badgeteam/ecsc21-badge-public/README.md

# ecsc21-badge-public
Hardware design files for the ENISA ECSC21 badge (software coming later)
