badgeteam/ecsc21-badge-public/hardware/prod/3D renders/back.png

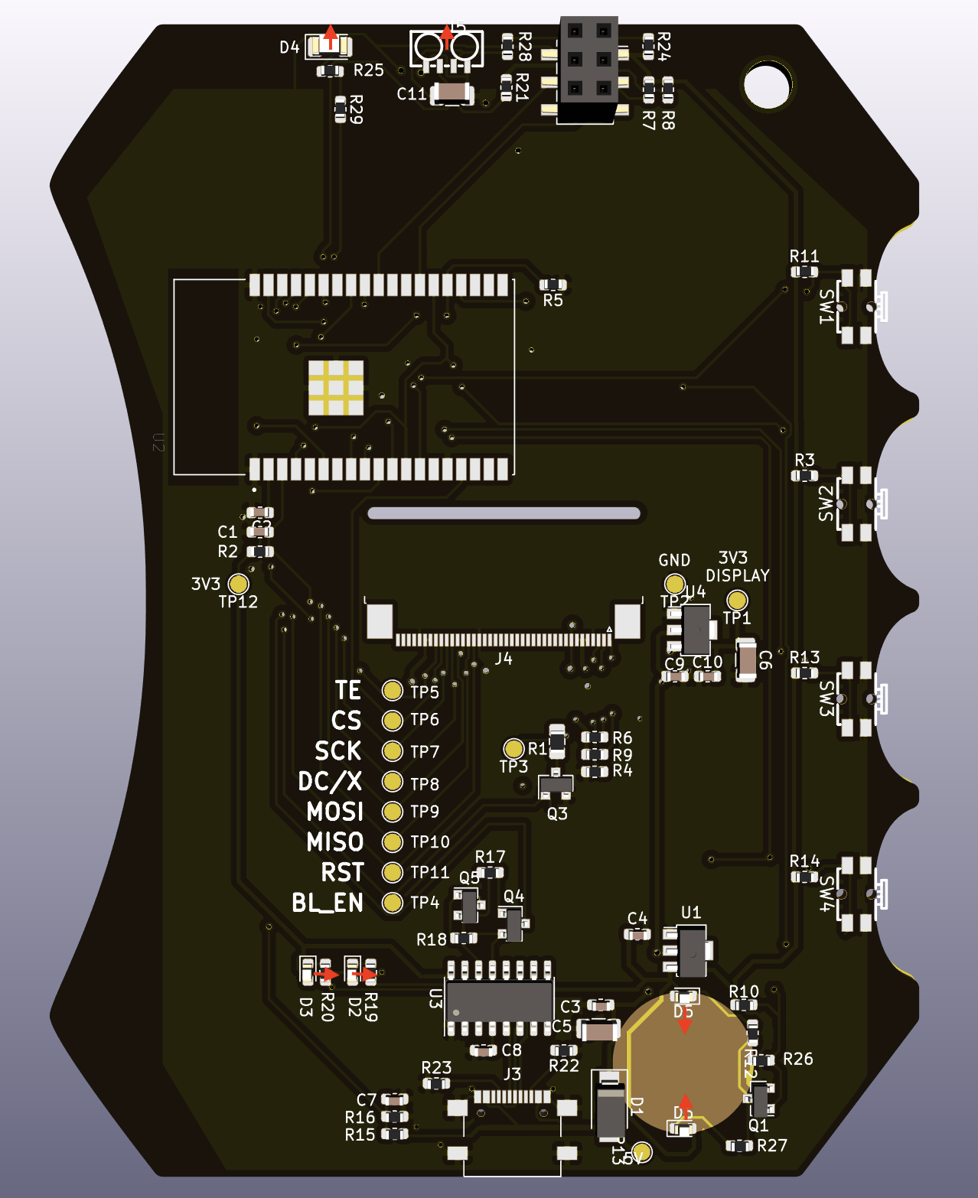
hardware/prod/3D renders/back.png
