badgeteam/ecsc21-badge-public/hardware/prod/3D renders/front.png

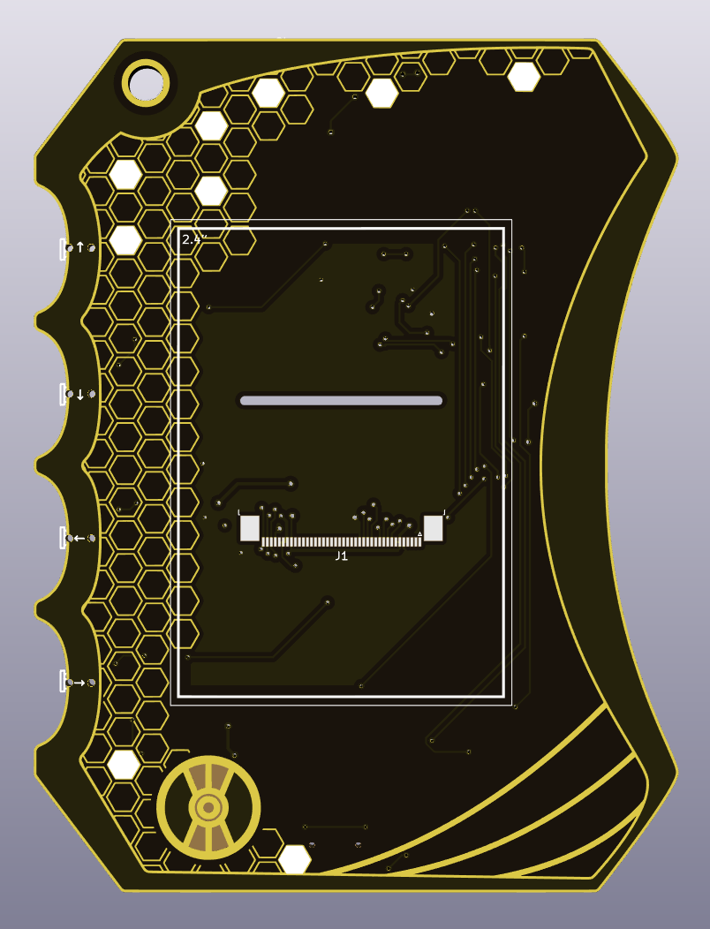
hardware/prod/3D renders/front.png
