badgeteam/ecsc21-badge-public/hardware/prod/BoM/ecsc21-badge.xlsx

Reference | Quantity | Value | Footprint | Datasheet | Notes
C1 C2 C7 C8 | 4 | 100nF | Capacitor_SMD:C_0603_1608Metric | ~
C11 | 1 | 10uF | Capacitor_SMD:C_1206_3216Metric | ~
C3 C4 C9 C10 | 4 | 1uF | Capacitor_SMD:C_0603_1608Metric | ~
C5 C6 | 2 | 10uf | Capacitor_SMD:C_1206_3216Metric | ~
D1 | 1 | 3A 0.5 Vf | Diode_SMD:D_SMA | https://lcsc.com/product-detail/Schottky-Barrier-Diodes-SBD_SS34_C183891.html
D2 | 1 | BLUE | LED_SMD:LED_0603_1608Metric | ~
D3 | 1 | GREEN | LED_SMD:LED_0603_1608Metric | ~
D4 | 1 | IR12-21C/TR8 | LED_SMD:LED_1206_3216Metric | https://datasheet.lcsc.com/szlcsc/1809192013_Everlight-Elec-IR12-21C-TR8_C53672.pdf
D5 D6 | 2 | Orange LTST-S270KFKT_C160472 | LED_SMD:LED_0603_1608Metric | https://datasheet.lcsc.com/szlcsc/Lite-On-LTST-S270KFKT_C160472.pdf
J1 J4 | 2 | Z240IT008 240x320 RGB TFT | Connector_FFC-FPC:TE_4-1734839-0_1x40-1MP_P0.5mm_Horizontal | See Nick's recommended connector, with the black securing tab at the bottom.
J2 | 1 | Conn_02x03_Counter_Clockwise | DNP | ~
J3 | 1 | USB_C_Receptacle_USB2.0 | Connector_USB:USB_C_Receptacle_China_SMT | https://www.usb.org/sites/default/files/documents/usb_type-c.zip
J5 | 1 | Conn_01x04_Female | OPTO-SMD_IRM-V840C_TR1:OPTO-SMD_IRM-V840C_TR1 | https://lcsc.com/product-detail/Others_Everlight-Elec-IRM-V840C-TR1_C264267.html
Q3 Q1 Q4 Q5 | 4 | AO3400 (A09T) | Package_TO_SOT_SMD:SOT-23 | http://www.aosmd.com/pdfs/datasheet/ao3400.pdf
R1 | 1 | 6.8 Ohm (1/4W) | Resistor_SMD:R_0805_2012Metric_Pad1.15x1.40mm_HandSolder | ~
R10 | 1 | DNP | DNP | ~
R2 R5 R15 R16 R11 R13 R14 R3 R4 R6 R9 R26 R21 R17 R18 | 15 | 10k | Resistor_SMD:R_0603_1608Metric | ~
R25 R24 R12 R27 R28 R29 | 6 | 47 Ohm | Resistor_SMD:R_0603_1608Metric | ~
R8 R7 R22 R23 R19 R20 | 6 | 5k1 | Resistor_SMD:R_0603_1608Metric | ~
SW1 SW2 SW3 SW4 | 4 | XUNPU TS-1014S-26 | SW-SMD_4P-L4.7-W4.5-P1.70-LS5.5-EH | https://lcsc.com/product-detail/Tactile-Switches_XUNPU-TS-1014S-26_C455255.html
U1 U4 | 2 | XC6206P332PR | Package_TO_SOT_SMD:SOT-89-3 | https://www.torexsemi.com/file/xc6206/XC6206.pdf
U2 | 1 | ESP32-WROOM-32D | esp32-wrover:XCVR_ESP32-WROVER | https://www.espressif.com/sites/default/files/documentation/esp32-wroom-32d_esp32-wroom-32u_datasheet_en.pdf | 4MB flash is fine
U3 | 1 | CH340C | Package_SO:SOIC-16_3.9x9.9mm_P1.27mm | https://www.mpja.com/download/35227cpdata.pdf
