badgeteam/ecsc21-badge-public/hardware/prod/pdf/ecsc21-badge-B_SilkS.pdf

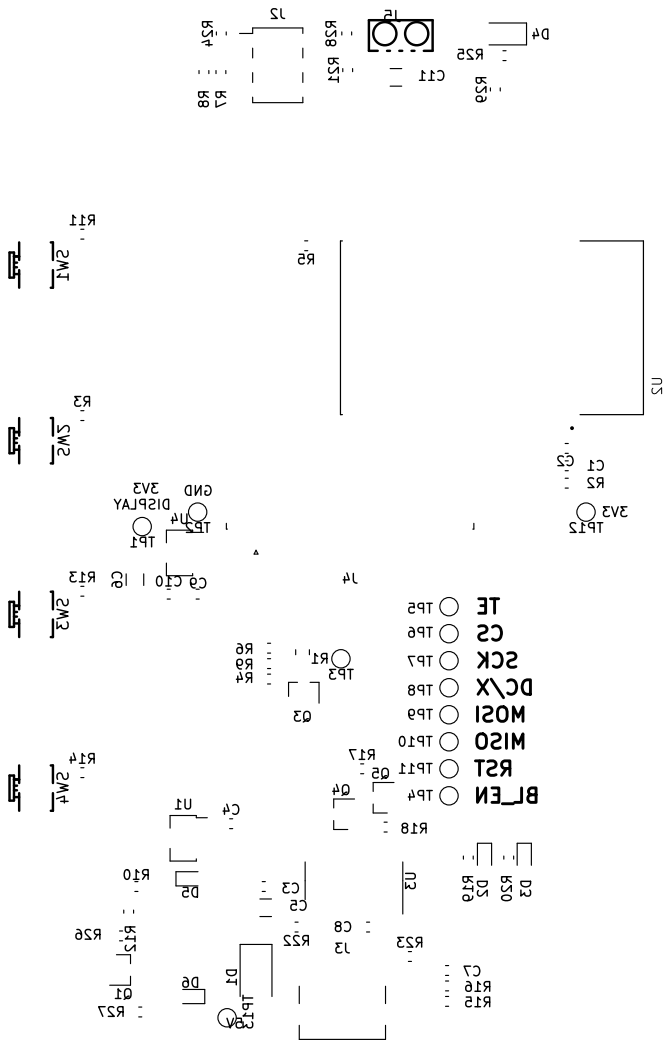
[picture p3: page 1]

GND RST MISO MOSI DC/X
