badgeteam/ecsc21-badge-public/hardware/prod/pdf/ecsc21-badge.pdf

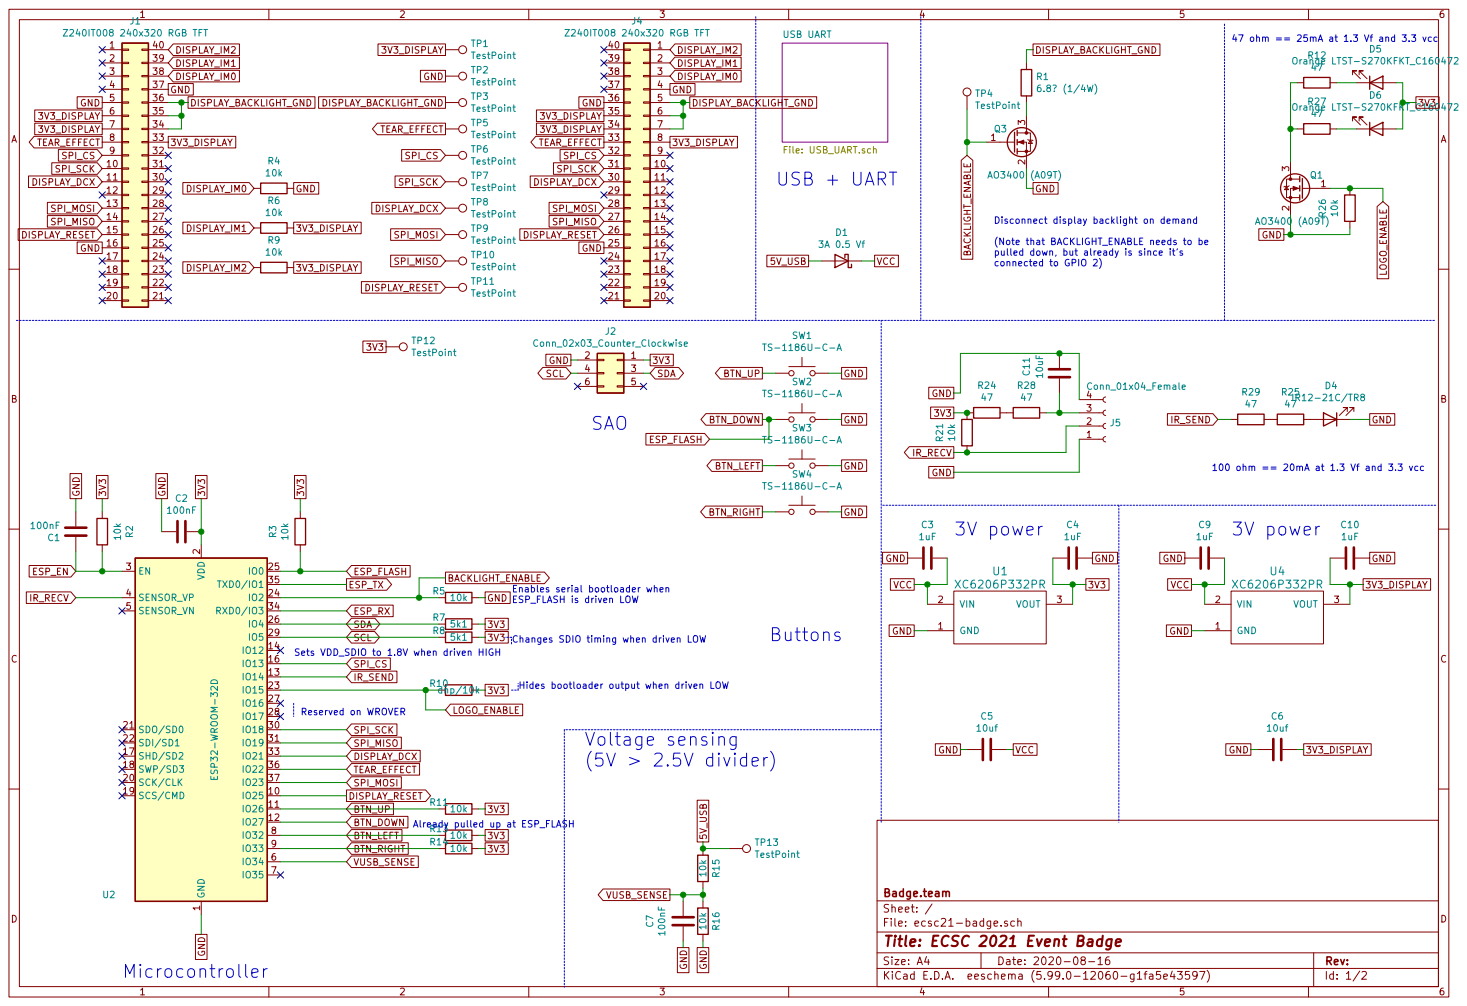
[picture p4: page 1]

47 ohm == 25mA at 1.3 Vf and 3.3 vcc

35 | 3V3_DISPLAY GND 6

Disconnect display backlight on demand

(Note that BACKLIGHT_ENABLE needs to be
connected to GPIO 2)

100 ohm == 20mA at 1.3 Vf and 3.3 vcc SAO

3V power Reserved on WROVER

2 SCK/CLK 20 SDO/SD0 21 SDI/SD1 22

Changes SDIO timing when driven LOW

Sets VDD_SDIO to 1.8V when driven HIGH

Hides bootloader output when driven LOW

Already pulled up at ESP_FLASH

File: ecsc21-badge.sch Sheet: / Badge.team

Id: 1/2 Title: ECSC 2021 Event Badge

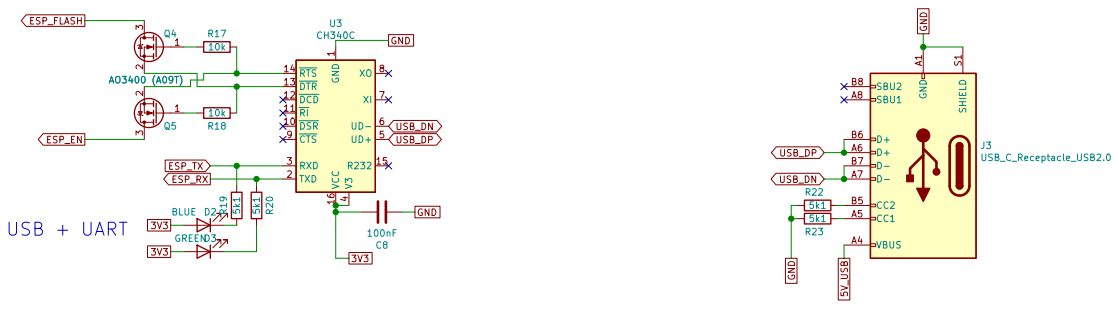
[picture p5: page 2]

4 UD+ 5 UD- 6 XI 7 XO 8 ~{CTS} 9 U3 CH340C GND A1 VBUS A4 CC1 A5 D+ A6 D- A7 SBU1 A8 CC2 B5 D+ B6 D- B7 SBU2 B8 SHIELD S1

1 ~{DSR} 10 ~{RI} 11 ~{DCD} 12 ~{DTR} 13 ~{RTS} 14 R232 15 VCC 16 TXD 2 RXD 3 V3

File: USB_UART.sch Sheet: /USB UART/ GREEND3 BLUE D2
