badgeteam/ecsc21-badge-public/hardware/prod/pdf/ecsc21-badge-B_CrtYd.pdf

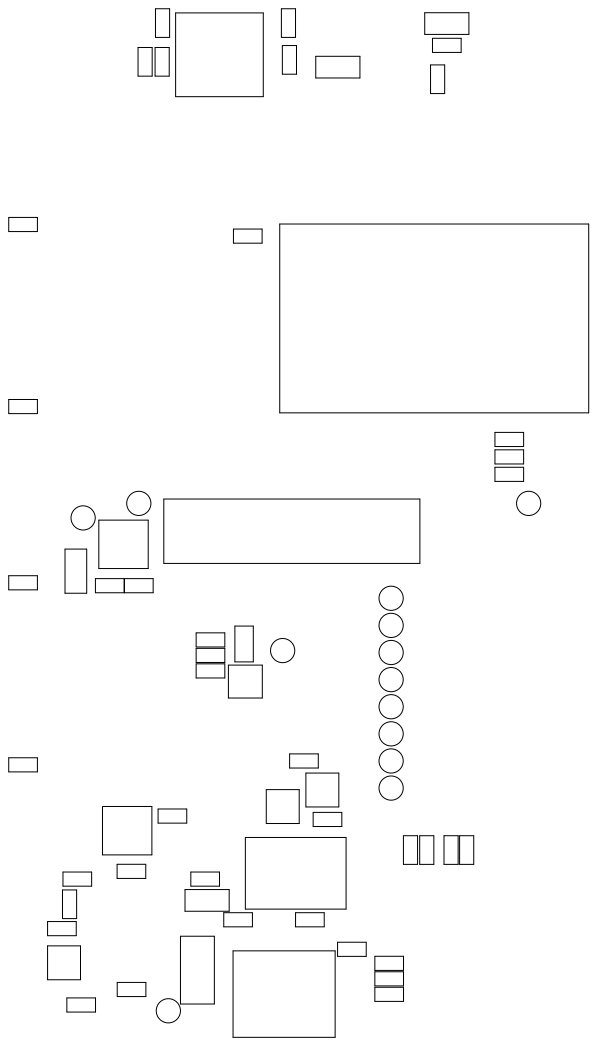
[picture p6: page 1]
