badgeteam/ecsc21-badge-public/hardware/prod/pdf/ecsc21-badge-B_Cu.pdf

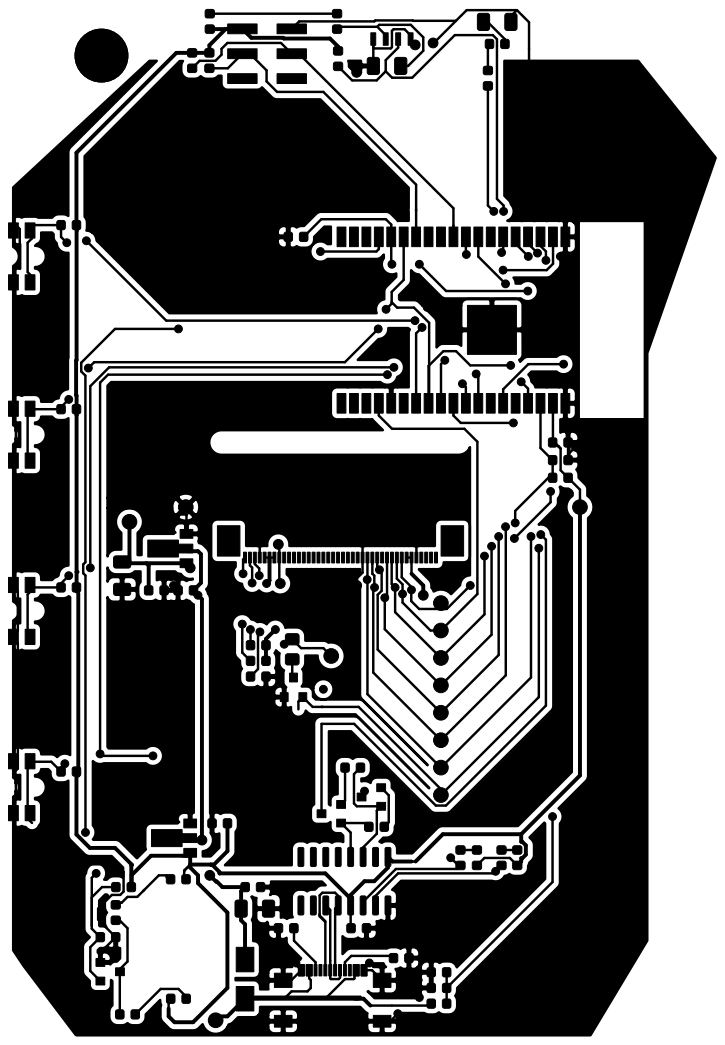
[picture p7: page 1]
