badgeteam/ecsc21-badge-public/hardware/prod/pdf/ecsc21-badge-B_Fab.pdf

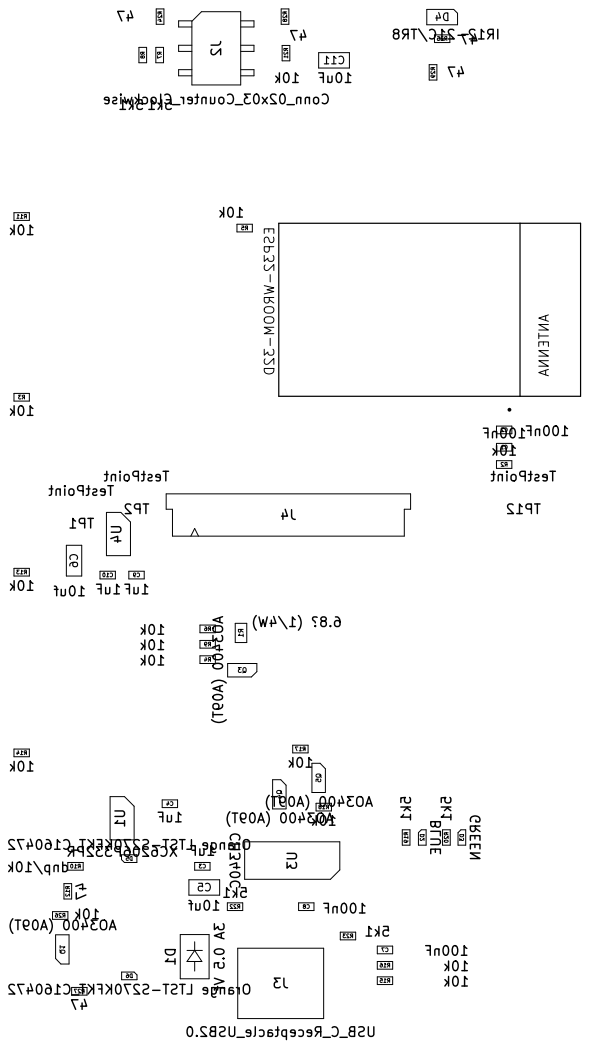
[picture p8: page 1]
