badgeteam/ecsc21-badge-public/hardware/prod/pdf/ecsc21-badge-B_Mask.pdf

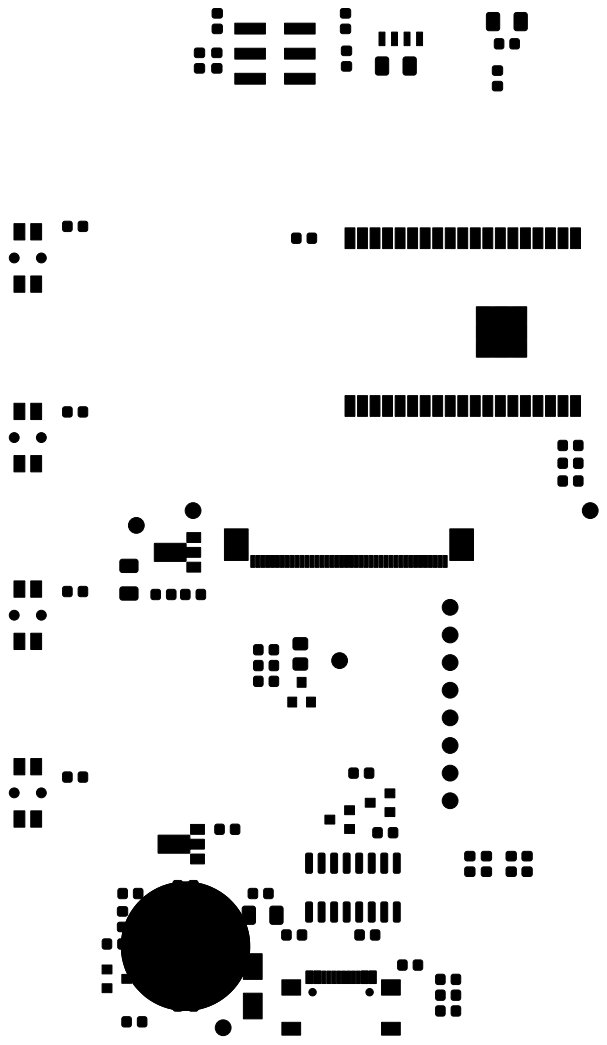
[picture p9: page 1]
