badgeteam/ecsc21-badge-public/hardware/prod/pdf/ecsc21-badge-B_Paste.pdf

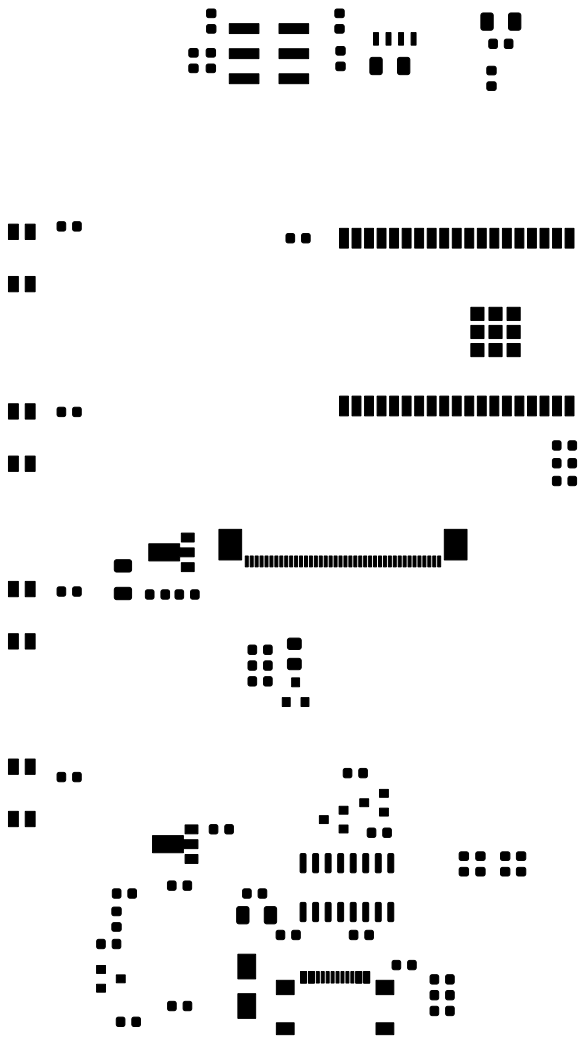
[picture p10: page 1]
