badgeteam/ecsc21-badge-public/hardware/prod/pdf/ecsc21-badge-Edge_Cuts.pdf

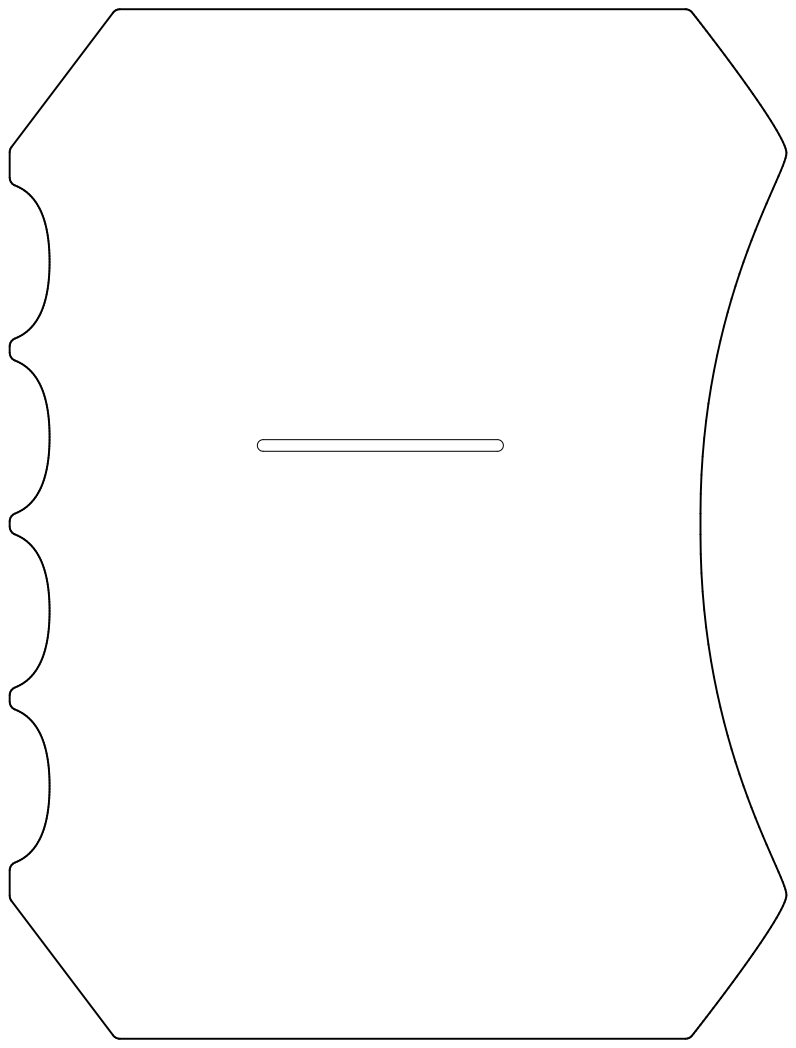
[picture p11: page 1]
