badgeteam/ecsc21-badge-public/hardware/prod/pdf/ecsc21-badge-F_Cu.pdf

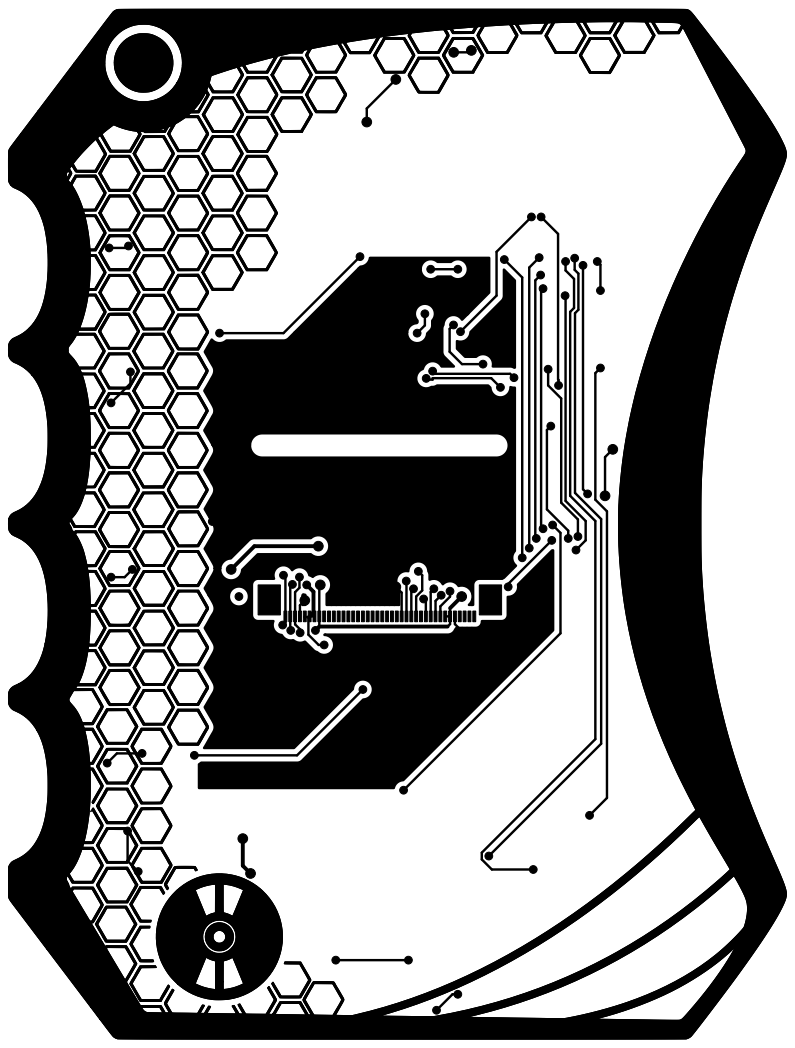
[picture p12: page 1]
