badgeteam/ecsc21-badge-public/hardware/prod/pdf/ecsc21-badge-F_Mask.pdf

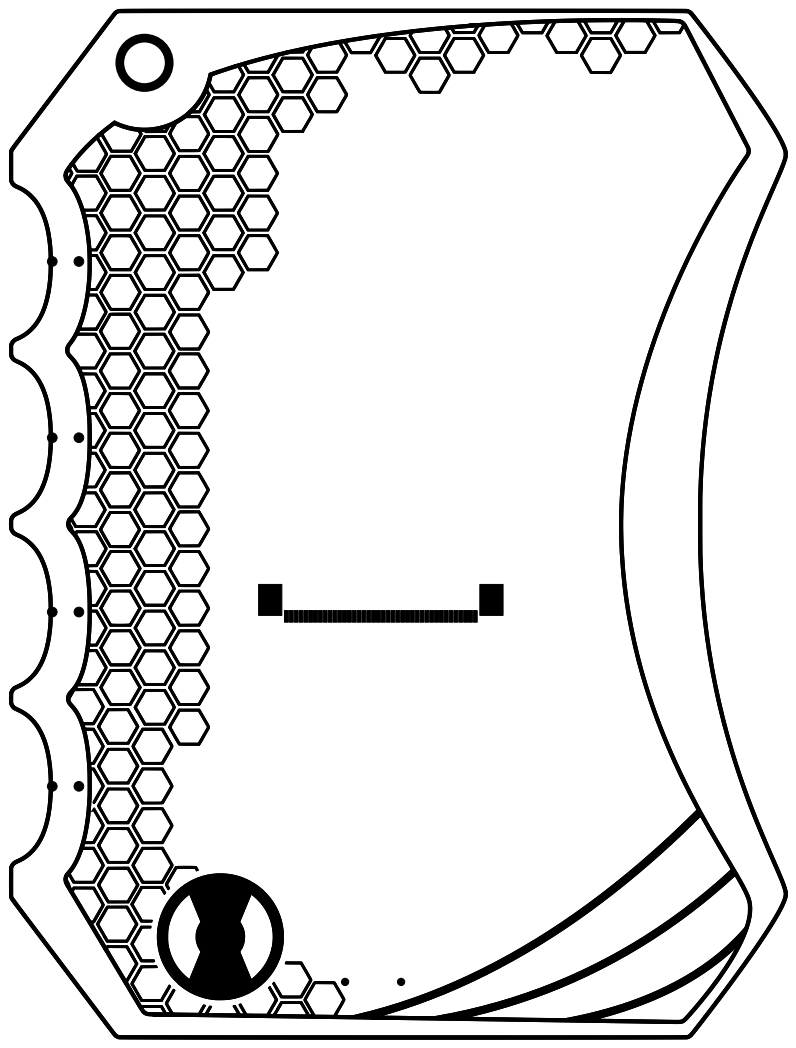
[picture p13: page 1]
