badgeteam/ecsc21-badge-public/hardware/prod/pdf/ecsc21-badge-F_SilkS.pdf

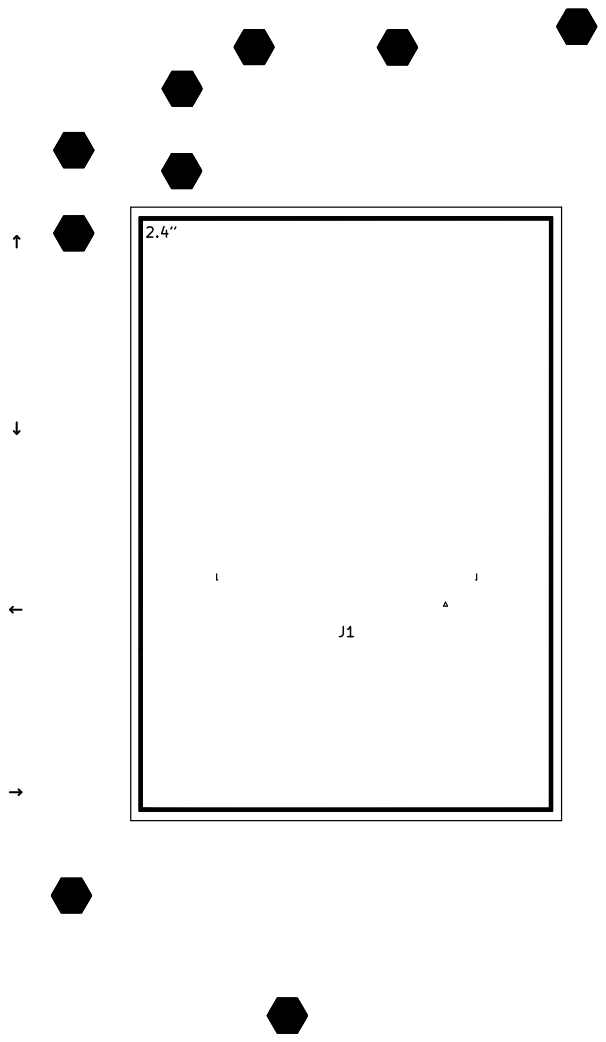
[picture p14: page 1]
