badgeteam/ecsc21-badge-public/hardware/ecsc21-badge.kicad_pcb

## KiCad design hardware/ecsc21-badge.kicad_pcb (2021-10-22)

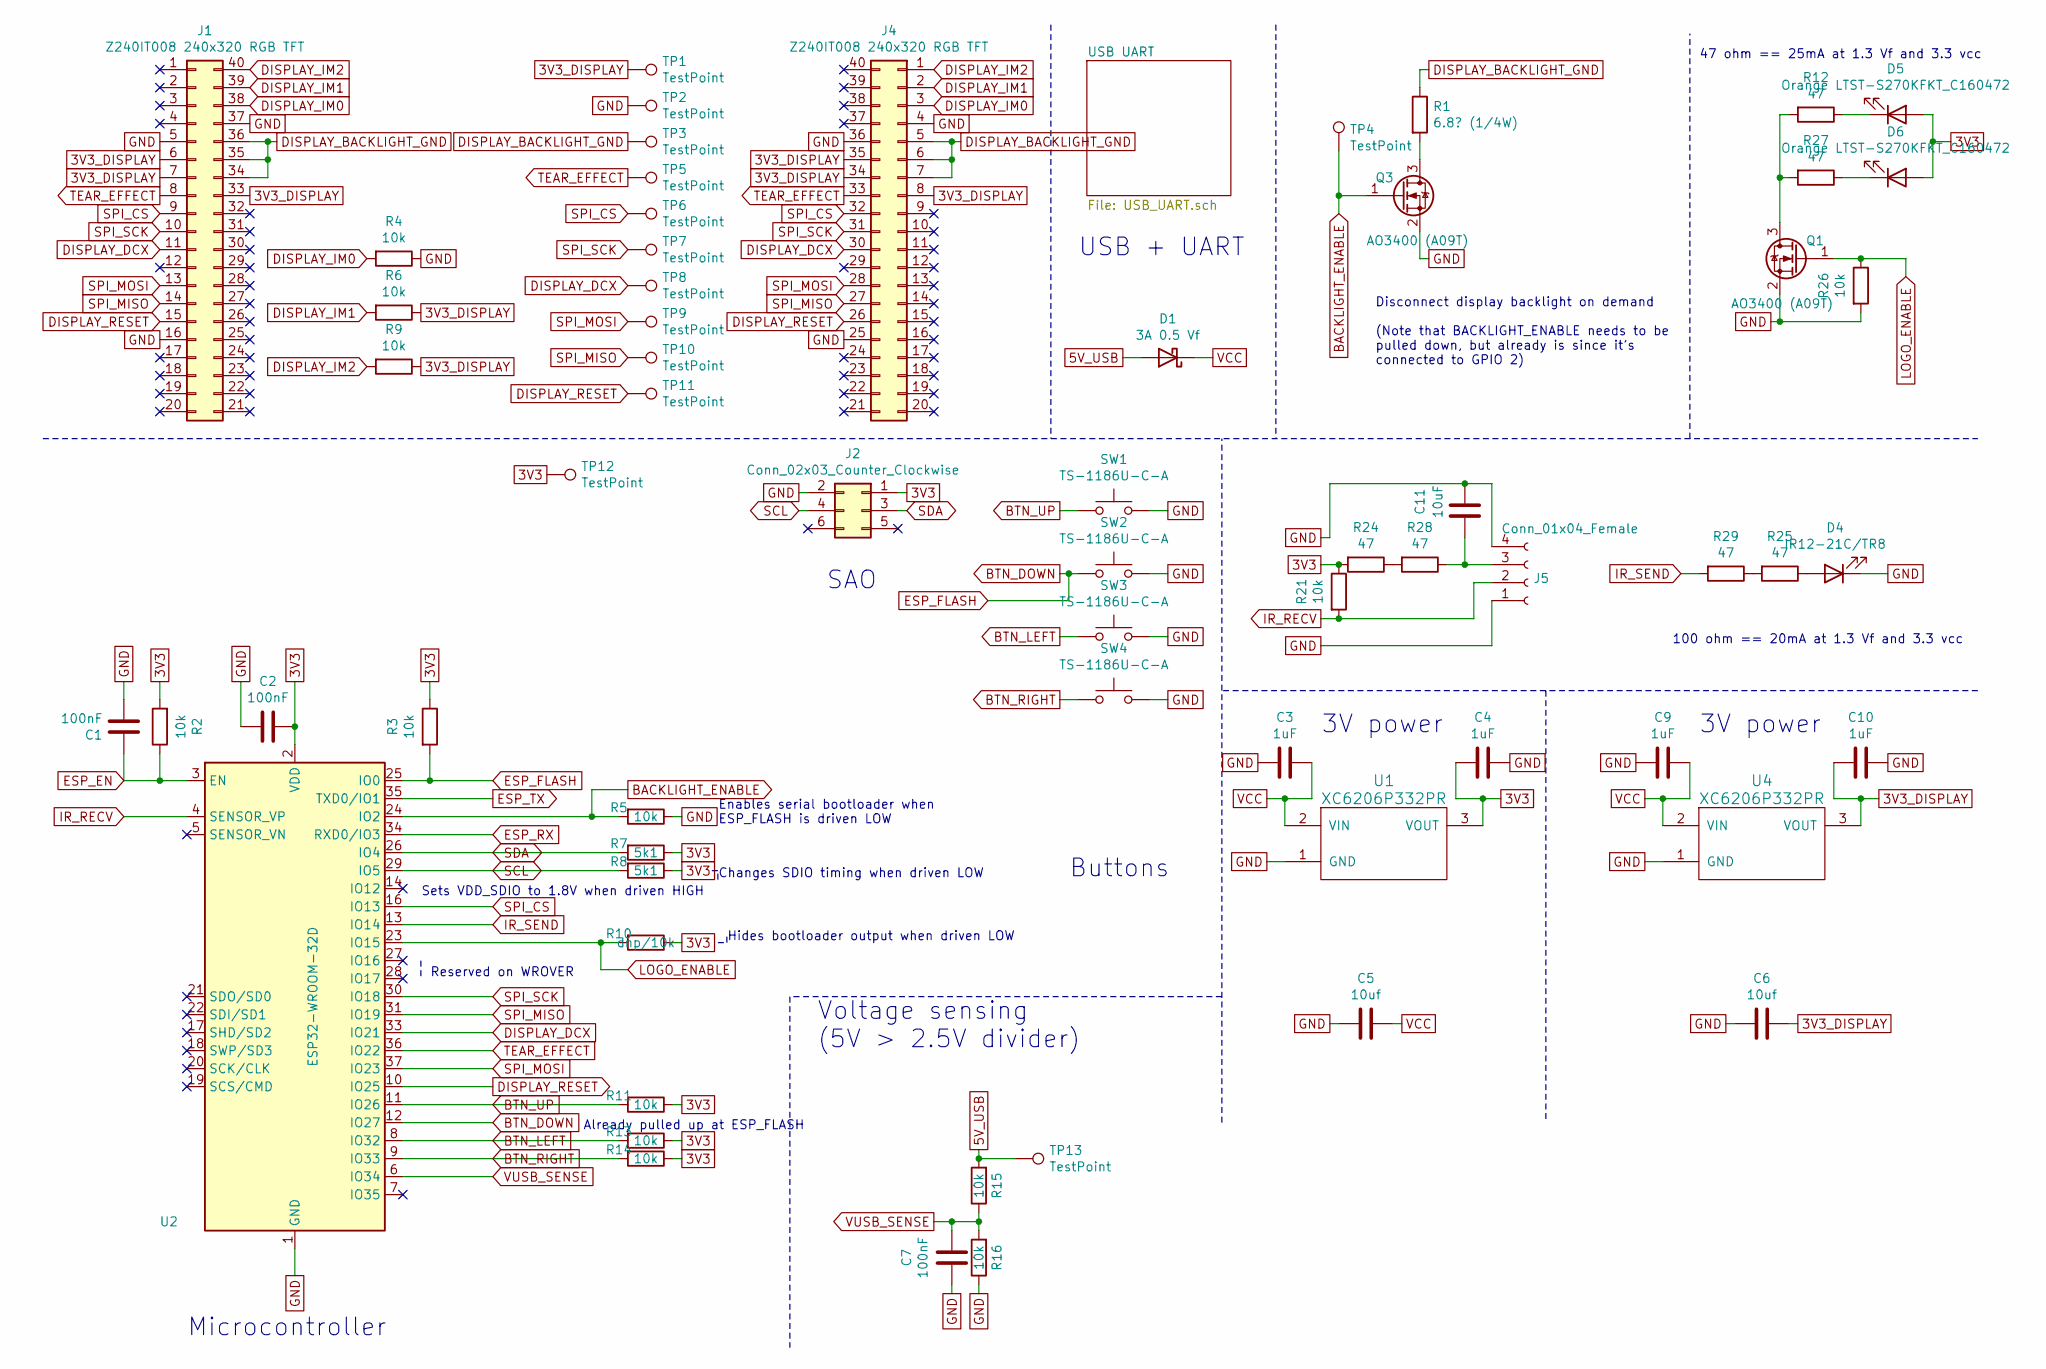
[picture p15: schematic ecsc21-badge.sch, ECSC 2021 Event Badge]

Parts:
C1, C2, C7: 100nF; C_0603_1608Metric
C3, C4, C9, C10: 1uF; C_0603_1608Metric
C5, C6: 10uf; C_1206_3216Metric
C11: 10uF; C_1206_3216Metric
D1: 3A 0.5 Vf; D_SMA
D4: IR12-21C/TR8; LED_1206_3216Metric
D5, D6: Orange LTST-S270KFKT_C160472; LED_0603_1608Metric
J1, J4: Z240IT008 240x320 RGB TFT; TE_4-1734839-0_1x40-1MP_P0.5mm_Horizontal
J2: Conn_02x03_Counter_Clockwise; PinSocket_2x03_P2.54mm_Vertical_SMD
J5: Conn_01x04_Female; OPTO-SMD_IRM-V840C_TR1
Q1, Q3: AO3400 (A09T); SOT-23
R1: 6.8? (1/4W); R_0805_2012Metric_Pad1.15x1.40mm_HandSolder
R2, R3, R4, R5, R6, R9, R11, R13, R14, R15, R16, R21, R26: 10k; R_0603_1608Metric
R7, R8: 5k1; R_0603_1608Metric
R10: dnp/10k; R_0603_1608Metric
R12, R24, R25, R27, R28, R29: 47; R_0603_1608Metric
SW1, SW2, SW3, SW4: TS-1186U-C-A; SW-SMD_4P-L4.7-W4.5-P1.70-LS5.5-EH
TP1, TP2, TP3, TP4, TP5, TP6, TP7, TP8, TP9, TP10, TP11, TP12, TP13: TestPoint; TestPoint_Pad_D1.5mm
U1, U4: XC6206P332PR; SOT-89-3
U2: ESP32-WROOM-32D; XCVR_ESP32-WROVER

Connections:
3V3: C2.1, C4.1, D5.2 (A), D6.2 (A), J2.1, R2.2, R3.1, R7.1, R8.1, R10.1, R11.1, R13.1, R14.1, R21.1, R24.2, TP12.1, U1.3 (VOUT), U2.2 (VDD); also elsewhere on the board
3V3_DISPLAY: C6.1, C10.1, J1.6, J1.7, J1.33, J4.8, J4.34, J4.35, R6.1, R9.1, TP1.1, U4.3 (VOUT)
5V_USB: D1.2 (A), R15.2, TP13.1; also elsewhere on the board
BACKLIGHT_ENABLE: Q3.1 (G), R5.2, TP4.1, U2.24 (IO2)
BTN_DOWN: R3.2, SW2.1, U2.12 (IO27), U2.25 (IO0); also elsewhere on the board
BTN_LEFT: R13.2, SW3.1, U2.8 (IO32)
BTN_RIGHT: R14.2, SW4.1, U2.9 (IO33)
BTN_UP: R11.2, SW1.1, U2.11 (IO26)
DISPLAY_BACKLIGHT_GND: J1.34, J1.35, J1.36, J4.5, J4.6, J4.7, R1.1, TP3.1
DISPLAY_DCX: J1.11, J4.30, TP8.1, U2.33 (IO21)
DISPLAY_IM0: J1.38, J4.3, R4.2
DISPLAY_IM1: J1.39, J4.2, R6.2
DISPLAY_IM2: J1.40, J4.1, R9.2
DISPLAY_RESET: J1.15, J4.26, TP11.1, U2.10 (IO25)
ESP_EN: C1.1, R2.1, U2.3 (EN); also elsewhere on the board
ESP_RX: U2.34 (RXD0/IO3); also elsewhere on the board
ESP_TX: U2.35 (TXD0/IO1); also elsewhere on the board
GND: C1.2, C2.2, C3.1, C4.2, C5.2, C6.2, C7.2, C9.1, C10.2, C11.1, D4.1 (K), J1.5, J1.16, J1.37, J2.2, J4.4, J4.25, J4.36, J5.1, J5.4, Q1.2 (S), Q3.2 (S), R4.1, R5.1, R16.1, R26.2, SW1.2, SW2.2, SW3.2, SW4.2, TP2.1, U1.1 (GND), U2.1 (GND), U2.15 (GND), U2.38 (GND), U2.39 (GND), U4.1 (GND); also elsewhere on the board
IR_RECV: J5.2, R21.2, U2.4 (SENSOR_VP)
IR_SEND: R29.2, U2.13 (IO14)
LOGO_ENABLE: Q1.1 (G), R10.2, R26.1, U2.23 (IO15)
unnamed: C11.2, J5.3, R28.1
unnamed: D4.2 (A), R25.1
unnamed: D5.1 (K), R12.1
unnamed: D6.1 (K), R27.1
unnamed: Q1.3 (D), R12.2, R27.2
unnamed: Q3.3 (D), R1.2
unnamed: R24.1, R28.2
unnamed: R25.2, R29.1
SCL: J2.4, R8.2, U2.29 (IO5)
SDA: J2.3, R7.2, U2.26 (IO4)
SPI_CS: J1.9, J4.32, TP6.1, U2.16 (IO13)
SPI_MISO: J1.14, J4.27, TP10.1, U2.31 (IO19)
SPI_MOSI: J1.13, J4.28, TP9.1, U2.37 (IO23)
SPI_SCK: J1.10, J4.31, TP7.1, U2.30 (IO18)
TEAR_EFFECT: J1.8, J4.33, TP5.1, U2.36 (IO22)
VCC: C3.2, C5.1, C9.2, D1.1 (K), U1.2 (VIN), U4.2 (VIN)
VUSB_SENSE: C7.1, R15.1, R16.2, U2.6 (IO34)

Notes on the sheet:
Hides bootloader output when driven LOW
Changes SDIO timing when driven LOW
Enables serial bootloader when ESP_FLASH is driven LOW
USB + UART
3V power
Microcontroller
Voltage sensing (5V > 2.5V divider)
Disconnect display backlight on demand (Note that BACKLIGHT_ENABLE needs to be pulled down, but already is since it’s connected to GPIO 2)
SAO
Buttons
Sets VDD_SDIO to 1.8V when driven HIGH
Reserved on WROVER
Already pulled up at ESP_FLASH
100 ohm == 20mA at 1.3 Vf and 3.3 vcc
47 ohm == 25mA at 1.3 Vf and 3.3 vcc

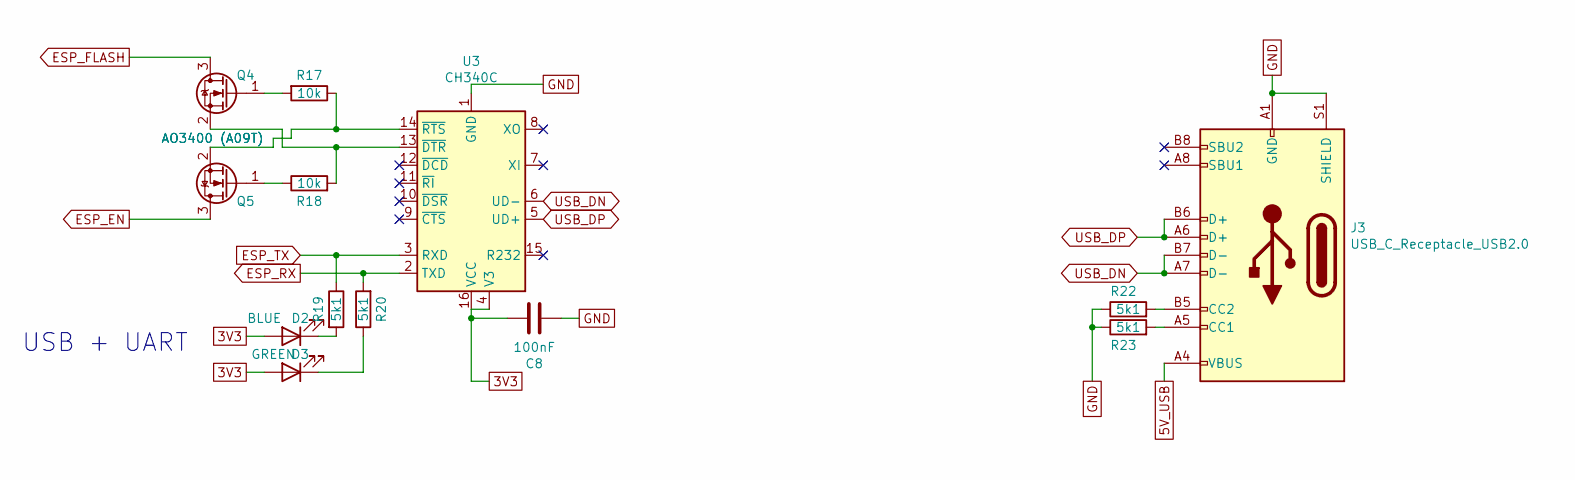
[picture p16: schematic USB_UART.sch]

Parts:
C8: 100nF; C_0603_1608Metric
D2: BLUE; LED_0603_1608Metric
D3: GREEN; LED_0603_1608Metric
J3: USB_C_Receptacle_USB2.0; USB_C_Receptacle_China_SMT
Q4, Q5: AO3400 (A09T); SOT-23
R17, R18: 10k; R_0603_1608Metric
R19, R20, R22, R23: 5k1; R_0603_1608Metric
U3: CH340C; SOIC-16_3.9x9.9mm_P1.27mm

Connections:
3V3: C8.2, D2.2 (A), D3.2 (A), U3.4 (V3), U3.16 (VCC); also elsewhere on the board
5V_USB: J3.A4 (VBUS), J3.A9 (VBUS), J3.B4 (VBUS), J3.B9 (VBUS); also elsewhere on the board
BTN_DOWN: Q4.3 (D); also elsewhere on the board
ESP_EN: Q5.3 (D); also elsewhere on the board
ESP_RX: R20.2, U3.2 (TXD); also elsewhere on the board
ESP_TX: R19.1, U3.3 (RXD); also elsewhere on the board
GND: C8.1, J3.A1 (GND), J3.A12 (GND), J3.B1 (GND), J3.B12 (GND), J3.S1 (SHIELD), R22.1, R23.1, U3.1 (GND); also elsewhere on the board
unnamed: D2.1 (K), R19.2
unnamed: D3.1 (K), R20.1
unnamed: J3.A5 (CC1), R23.2
unnamed: J3.B5 (CC2), R22.2
unnamed: Q4.1 (G), R17.2
unnamed: Q4.2 (S), R18.2, U3.13 (~DTR)
unnamed: Q5.1 (G), R18.1
unnamed: Q5.2 (S), R17.1, U3.14 (~RTS)
USB_DN: J3.A7 (D-), J3.B7 (D-), U3.6 (UD-)
USB_DP: J3.A6 (D+), J3.B6 (D+), U3.5 (UD+)

Notes on the sheet:
USB + UART

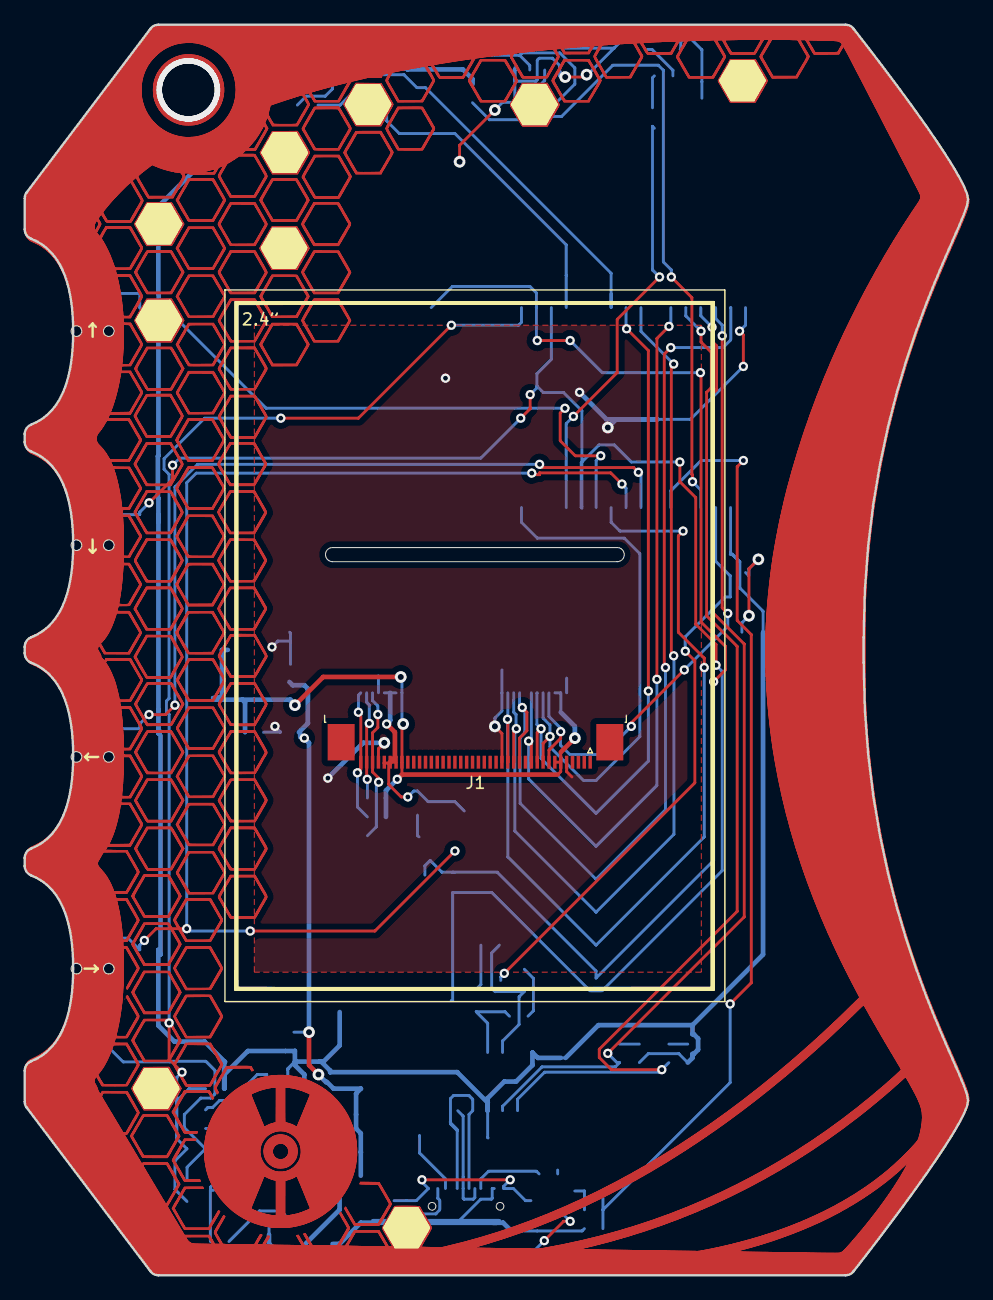
[picture p17: board ecsc21-badge.kicad_pcb from above]

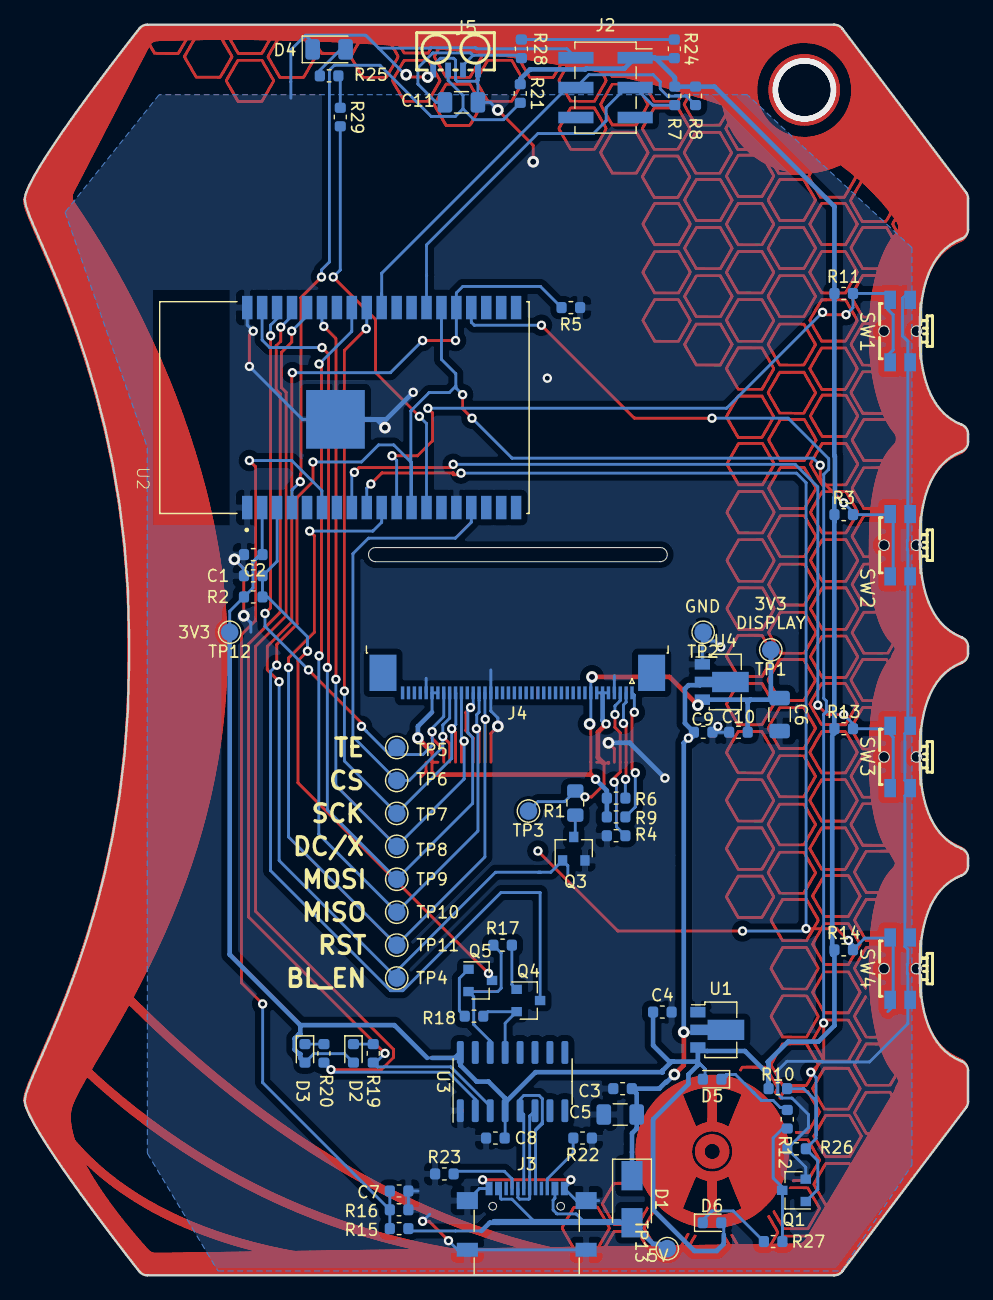
[picture p18: board ecsc21-badge.kicad_pcb from below]

Board: 2 copper layers, 80.2 x 106.3 mm, 76 parts (75 on the bottom side), 48 nets.
